JeyaVardhan-L/STM32-Flight_Telemetry/assets/dashboard-v1.png

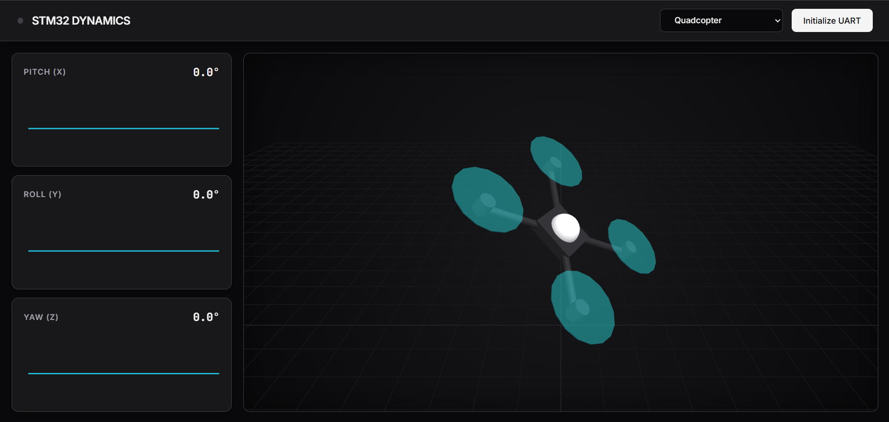
assets/dashboard-v1.png
