JeyaVardhan-L/STM32-Flight_Telemetry/(commit log)

2026-05-03 Revise README with project details and setup instructions
    Expanded project description and added detailed sections on hardware setup, core features, wiring guide, and instructions to run the telemetry dashboard.
2026-05-03 Add project report for STM32 Sensor Fusion dashboard
    Documented the project journey, challenges faced, and solutions implemented for the STM32 Sensor Fusion and Real-Time Telemetry Dashboard.
2026-11-10 Firmware v2: complementary filter, gyro bias calibration, fixed 100 Hz loop
    - Fuse gyro and accelerometer for pitch/roll (alpha 0.98), correcting along
    the shortest angle so the estimate does not jump at +/-180 deg
    - Average the gyro for ~2 s at boot to remove bias (PC13 LED on meanwhile)
    - Yaw deadband of 0.5 deg/s to stop drift while resting
    - micros()-based dt and a fixed-rate scheduler instead of delay(10)/millis()
    - I2C at 400 kHz; fast LED blink and '#' error line if the MPU6050 is missing
    - '#'-prefixed status lines; data format unchanged (pitch,roll,yaw)
    v1 is preserved under tag v1.0-hackathon.
2026-11-10 Dashboard v2: monochrome redesign, demo mode, recording, robust serial
    - Split the single-file page into web/style.css, models.js, telemetry.js, app.js
    - Demo mode replays demo/flight.csv (clearly labelled simulated); ?demo autostarts
    - Record button exports raw samples as CSV in the same format
    - Disconnect button, unplug handling, on-screen errors, Web Serial support check
    - Strict CSV parsing so truncated lines are dropped instead of read as zeros
    - Chart updates batched per animation frame; line breaks at +/-180 wraps
    - Pin Chart.js to 4.4.1; responsive layout down to phone width
2026-11-10 Assets: wiring diagram, v2 screenshot, demo GIF, compressed images
    - assets/wiring.svg: accurate wiring diagram from the real pin map
    - Keep the illustrated breadboard view (compressed 5.6 MB -> 0.7 MB)
    - hardware.jpg replaces Finmodule.png (same photo, 0.9 MB -> 0.12 MB)
    - GIF from the original hardware test video for the README
    - Rename files descriptively (Web.png -> dashboard-v1.png, Testing.mp4 -> hardware-test.mp4)
2026-11-10 Docs: rewrite README, add post-ship audit to the dev log, MIT license
    - README matches the code: hardware, wiring (with the TX->TX explanation),
    setup, protocol, the math, engineering lessons, limitations, roadmap
    - Report.md keeps the original log and adds post-ship notes plus Cycle 9,
    the audit that found the documentation/code mismatch
